jdgiffs237-cmd/home-radar/2.0/docs/stepper-wiring.html

# Stepper Upgrade Wiring

The 28BYJ-48 stepper motor + its green ULN2003 driver board, steered by the joystick — everything powered from the Arduino's 5V (USB). Six jumper wires plus one capacitor, and the motor's own cable just clicks into the driver's white socket.

Six jumpers: four signal wires (D2–D5 → IN1–IN4), plus 5V and GND shared by the driver and the joystick. The capacitor across the rails is a tiny local reservoir that feeds the motor's split-second spikes so the Arduino's 5V never dips.

The 2.0 radar, complete: stepper sweeps (top diagram), sensor pings (this one), D10/D11 were kept free for exactly this moment.

From (Arduino) | To | Suggested jumper
D2 | ULN2003 IN1 | orange
D3 | ULN2003 IN2 | yellow
D4 | ULN2003 IN3 | green
D5 | ULN2003 IN4 | blue
5V | ULN2003 «+» and joystick VCC | red (via breadboard rail)
GND | ULN2003 «−» and joystick GND | black (via breadboard rail)
5V ↔ GND rails | electrolytic capacitor, 100–470 µF — stripe (−) to GND | (sits on the breadboard)
A0 | joystick VRx | purple / white
D10 | HC-SR04 TRIG | blue
D11 | HC-SR04 ECHO | purple
5V / GND rails | HC-SR04 VCC / GND | red / black

### Why D2–D5?

Deliberately avoids D9/D10/D11, which the radar uses for the servo and the ultrasonic sensor — so later the stepper and the sensor can be wired at the same time.

### Servo vs stepper

A servo is told an angle; a stepper is told "take N steps" and doesn't know where it is. Precise and repeatable (2048 steps per turn ≈ 0.18° each!), but it needs a known starting position — point it straight ahead by hand before powering up.

### The USB power budget

A USB port gives ~500 mA. Motor 240 + Arduino 50 + sensors ~20 ≈ 310 mA — it fits, with modest headroom. Two rules keep it happy: the capacitor stays in (it absorbs the motor's split-second spikes), and the sketch releases the coils when idle so the motor only drinks while actually moving. If things ever get flaky, plug into a rear PC port or a powered hub rather than a laptop's side port.
