jdgiffs237-cmd/home-radar/2.0/debug/current_test/amp-check.html

# Amp Check

Two measurements with the multimeter: how much current the motor eats, vs how much the Arduino itself sips. The trick both times: current is measured in series — the meter becomes part of the wire, so electricity flows through it.

## ⚠ Before touching the dial

- Move the red probe to the 10A socket on the meter (not the mA one — the motor's current can blow the mA fuse). Dial to DC amps (A⎓).
- The meter goes in the middle of a broken wire — never across two power pins. Across = short circuit = blown fuse (or worse).
- When you're done, move the red probe back to the V socket. Leaving it on 10A and later measuring a battery's voltage is the classic way to kill a meter.

Test 1 — unplug the red wire that feeds the ULN2003's «+», and reconnect it through the meter: 5V pin → red probe, black probe → «+». The meter now counts every electron the motor takes.

Test 2 — identical idea to Test 1, but the broken-and-rejoined wire is the power module's +5V feed to the driver. Now the meter is grading the battery: can it actually deliver what the motor asks for?

## What the numbers say

Measurement | Reading | Meaning
Test 1 — motor on Uno 5V | 0.24 A ✓ measured! | Textbook 28BYJ-48 draw. The motor and wiring are healthy.
Test 2 — motor on external power, good supply | ~0.24 A | Supply keeps up: same current, bright module light, clean stepping.
Test 2 — motor on external power, weak battery | noticeably less | Voltage sagging under load: dim light, buzzing, no rotation — your dead 9V, quantified.

The takeaway: the motor wants ~0.24 A all the time — even holding still, because the driver keeps the coils energized. A supply that can't sustain that sags, and you saw exactly what that looks like: dim light, buzz, no motion. Same wiring, same motor, same code — the only variable was the supply. That's real electrical debugging.
