jdgiffs237-cmd/home-radar/(commit log)

2026-09-15 Add servo test, joystick control, and hand-steered radar firmware
    - firmware/servo_test: one-shot 5s servo wiggle check
    - firmware/joystick_servo: joystick rate-controls the servo
    - firmware/radar_joystick: all three modules; joystick aims the beam,
    HC-SR04 pings, board streams the remembered picture in the same
    S/R/E protocol so the Python side is unchanged
    - .gitignore: keep receipts/ (personal purchase records) local
2026-09-18 Noise-proof the hand-steered radar; retire stepping-stone sketches
    radar_joystick v2: pings are settle-gated (no pings while the head is
    moving, whose vibration reads as phantom close echoes) and each stored
    range is the median of 3 pings so power-sag glitches get outvoted.
    run_live.py now auto-detects the Arduino port. Removed servo_test,
    joystick_servo, and hi.py to keep the tree lean; both retired sketches
    remain in history.
    [joystick_servo.ino, radar_joystick.ino]
2026-09-18 Auto-calibrate joystick center; clean up firmware
    Measure the stick's resting value at boot instead of assuming 512, so
    steering survives any supply voltage (USB, battery, a tired 9V) -- the
    root cause of the angle-drift debugging saga. Remove the temporary debug
    block and update the header wiring notes to match the power-module setup.
    [radar_joystick.ino]
2026-09-18 Guard joystick calibration against a disturbed boot
    If the stick is held or a wire is loose during the boot-time center
    measurement, the reading is nonsense and steering locks up. Only trust a
    plausibly-centered value (400-624); otherwise fall back to the nominal 512
    so a bad calibration can never brick steering. Report the result in the
    startup banner.
    [radar_joystick.ino]
2026-09-18 radar_joystick v3: paint while panning; mirrored-mount switch
    Ping in two modes, the search/track split: a slow-to-medium pan fires one
    quick ping per step so the picture paints live, while a parked head uses
    the filtered median-of-3. Full-stick slews still skip pings (vibration
    ghosts). Settle time 60->30 ms, frame rate 2->3.3 Hz. Readings under 15 cm
    while panning are dropped as mount ringing.
    Add MOUNT_FLIPPED for a rig turned around (servo 0-degree end on the
    left): mirrors the servo command and the stick together so the scope and
    the joystick keep matching the room. `angle` is now always the displayed
    bearing; aim() is the one place that knows the physical mounting.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
    [radar_joystick.ino]
2026-09-18 Restore joystick_servo (Level 1) with boot-time stick calibration
    Brought back the stick-drives-servo sketch as a playground: no sensor, no
    scope, just steering. Measures the stick's resting value at boot (with the
    plausibility fallback) so it works on the battery rail without drifting.
    [joystick_servo.ino]
2026-09-22 Restructure into 1.0 (servo) and 2.0 (stepper); add stepper radar
    - 1.0/: the complete servo-era project, unchanged, plus local copies of
    the visual guides in docs/ and the debug sketches
    - 2.0/: stepper-scanned radar (28BYJ-48 + ULN2003) speaking the same
    serial protocol, auto-sweep and joystick-steered firmware, hardware
    bring-up sketches, wiring diagrams, one-command run_radar.py viewer
    - BUILDLOG.md: build diary
    - New top-level README presenting both generations
    - Root .gitignore covering the whole tree (receipts, media, caches)
